Meta-II/LaTeXnote/Sun-机械设计基础课程设计.pdf

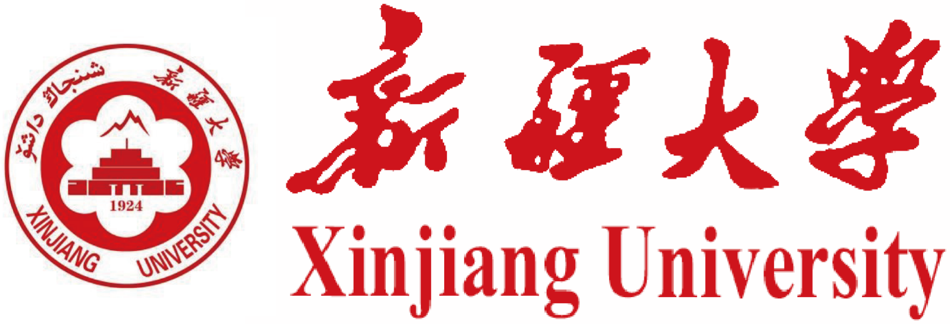
[picture p6: figure]

# 机械设计基础课程设计

# 说明书

## 设计题目： 带式运输机（二）

## 学生姓名： 田欣洋

学 号： 20192000226

## 所属院系： 机械工程学院

专 | 业： 机械工程
班 | 级： 材料 19-1 班

## 指导老师： 巴吾东·依不拉音

日 期： 2021.06.24

摘要

本文为机械设计基础的课程设计说明书文档，以蜗轮蜗杆减速器为例，从原 动机的选择开始到主要零部件的设计，一步步系统完备地设计出了减速器，本文 采取了 LATEX 排版，并使用了自动计算的命令，进一步简化了设计的繁琐步骤。 本文的源码可在github上获得 (https://github.com/Meta-II/LaTeXnote)

目 录

第一章 机械装置总体设计 | 3
第二章 传动零件的设计计算计 | 6
第三章 主要零部件设计 | 10
第四章 减速器箱体及附件的设计 | 19

新疆大学本科课程设计

参考文献 | 24

# 第一章 机械装置总体设计

1.1 任务书与方案拟定

本传动装置用于带式运输机, 其工作参数如下: 运输带工作拉力 2200 N, 运 输带工作速度 1.0 m/s, 运输带滚筒直径 380 mm 两班制工作, 连续单向运转, 工 作中有轻微振动. 运输带速度允许误差为 ±5% 使用期限为十年, 检修期间隔为 三年, 根据工作要求, 本设计拟采用蜗轮蜗杆减速器, 具体的传动装置简图如下:


图 1.1: 传动简图

其中 1: 电动机, 2: 弹性联轴器, 3: 蜗杆减速器, 4: 滚筒, 5: 带式运输机

1.2 原动机选择

1.2.1 电动机的选择

(1) 按照工作要求, 选择一般用途的 YE3 系列超高功率三相异步电动机, 电压 380V

(2) 选择电动机功率工作机所需效率为:

Pw =

F · v
1000

=

2200 · 1.0
1000

= 2.20 kW

传动装置总效率为:

η = η滚筒 · η联轴器 · η球轴承 · η蜗轮蜗杆 = 0.96¹

- 0.98³
- 0.99²
- 0.84 = 0.74

所需电动机功率为:

Pd =

Pw
η

= 2.96 kW =⇒ Ped = 3 kW

因为载荷平稳, 电动机额定功率 Ped 略大于 Pd 即可, 查表后, 选择电动机 的额定功率 Ped 为 3 kW.

(3) 确定电动机转速滚筒轴的工作转速为

nw =

60 · 1000 · 1.0
π · 380

= 50.26 m/s

一级蜗轮蜗杆减速器的传动比通常为 10 ∼ 20, 即 ia

′ = 10 ∼ 20, 故电动机
转速可选范围为:

nd
′ = ia

′ · nw = (10 ∼ 20) · nw = 502.59 ∼ 1005.19 m/s

符合这一范围的同步转速有 750r/min,1000r/min,查阅相关标准[1]
, 根据
功率, 转速, 挑选出以下两种型号电机, 并进行比较.
方案 | 电动机型号 | 额定功率 /kW | 同步转速/满载转速 nm | 重量 | 噪声 | 效率
1 | YE3-132S-6 | 3 | 1000/960(/ r/min) | 63kg | 69dB | 85.6%
2 | YE3-132M-8 | 3 | 750/730(/ r/min) | 61kg | 64dB | 82.5%

表 1.1: 电动机型号比较表

为了使传动装置结构紧凑稳固, 噪声更小, 效率更高, 选择方案 1, 确定电 机型号为 YE3-132S-6, 其主要参数: 满载转速 nm = 960 r/min, 中心高

H = 132 mm, 轴伸部分 D = 38 mm

1.2.2 传动比的分配

总传动比:ia =

| nm nw | =
| | 960
50.26 = 各个轴的传动比:i01 = 1,i12 = 19.10

1.2.3 传动系统运动与动力参数计算

0 轴 (电动机轴)

p0 = pd = 2.96 kW

n0 = nm = 960 r/min

T0 = 9550

P0
n0

= 9550 ×

2.96
960

= 29.42N · m

1 轴 (蜗杆轴)

p1 = p0η1 = 2.957491774667032 × 0.9702 = 2.87 kW

n1 =

n0

i01

=

960
1

= 960 r/min

T1 = 9550

P1
n1

= 9550 ×

2.87
960

= 28.54 N · m

2 轴 (蜗轮轴)

p2 = p1η2 = 2.87 × 0.84 = 2.41 kW

n2 =

n0

i12

=

960
19.10

= 50.26 r/min

T2 = 9550

P2
n2

= 9550 ×

2.41
50.26

= 457.98 N · m

根据以上计算结果, 列出各轴运动和动力参数表如下:

轴名 | 功率 P/kW | 转矩 T/N · m | 转速 | 传动比 | 效率
| 输入 | 输出 | 输入 | 输出 | n/(r/min) | i | η
电动机轴 | 3 | 2.96 | | 29.42 | 960
1 轴 | 2.87 | 2.84 | 28.54 | 28.26 | 960 | 1 | 0.97
2 轴 | 2.41 | 2.31 | 457.98 | 439.66 | 50.26 | 19.10 | 0.84

表 1.2: 各轴动力参数表

# 第二章 传动零件的设计计算计

根据第一章计算的数据: 电动机功率 Ped = 3 kW, 转速 n1 = 960 r/min, 传 动比 i12 = 19.10, 载荷平稳单向回转.

2.1 传动类型选择

根据 GB/T10085 − 1998 为了加工简便, 易于更换维修, 选择常用的右旋 渐开线蜗杆 (ZI 蜗杆), 精度等级为 7 级.

2.2 材料选择

根据工作要求, 蜗杆选择 45 号钢, 表面淬火处理, 硬度达到 45 ∼ 55 SRC, 蜗 轮选择含锡量较低的 5-5-5 ZCuSn5Pb5Zn5 的锡青铜金属模制造, 轮芯采用灰铸 铁 HT100 制造,

2.3 参数选择与强度计算

2.3.1 传动比计算

在较大的传动功率下, 为了提高效率, 采用多头蜗杆, 取 Z1 = 2, 取传动比为

19, 则误差为 ∆ = 19.101−19
19.101 ×100% = 0.53%, 在误差允许范围内. 再根据效率传动 比与蜗杆头数, 蜗轮齿数的关系:i12 =
| n1
| n2 = Z2
| Z1 , 计算得到:Z2 = Z1 · i12 = 2 · 19 =
38, 查表 12-8, 估计 η = 0.8

2.3.2 强度计算

因为圆柱蜗杆传动的主要失效形式为蜗轮轮齿表面产生胶合, 点蚀, 磨损, 所以根据蜗轮齿面疲劳接触强度进行设计计算. 已知蜗轮所受的的转矩 T2 = 457.983, 因为工作转速不大, 工作冲击不大, 环境温度不高, 故选择使用系数 KA = 1.20.因为蜗杆采用 45 号钢, 其硬度大于 45SRC, 蜗轮选择 ZCuSn5Pb5Zn5 的锡 青铜金属模制造, 单向旋转, 根据表 12-2 选取综合弹性系数 Ze = 160 , 查表 12-4, 许用接触应力 [σH] = 220Mpa, 查表 12-6, 许用弯曲用力 [σF ] = 28Mpa. Zp 为

接触系数, 先假设蜗杆分度圆直径 d1 和中心矩 a 的比值 d1 a = 0.37, 查表得到

Zp = 2.8.
根据赫兹公式, 得到蜗轮齿面疲劳接触强度的设计公式如下

a ≥
3

√

KAT

(ZeZp

[σH]

)2

所以中心矩为:

a ≥

3

√

1.20 × 447284.28 × 10³

(160 × 2.8

220

)2
= 131.597 mm

2.3.3 参数确定

### 1. 参数的估算与选择

d1 ≈ 0.68a

0.875 = 0.68 × 130.565⁰.875 = 48.62 mm

m ≈

2a − d1
Z2

=

2 × 130.565 − 48.290
38

= 5.646 mm

a = 0.5m(q + Z2) = 0.5 × 6.3(10 + 38) = 151.2 mm > 131.597 mm

查表 12-1 选择 m = 6.3 mm, d1 = 63 mm, q = 10.00, d2 = mZ2 = 6.3·38 =

239.4 mm 因为 a = 151.2 mm > 131.597 mm 故接触强度足够. 由蜗轮传动中心 矩的标准系列 (...,80,100,125,160,180,...), 选取中心矩 a = 160 mm, 但如果选取 此值, 则会引起传动比变化, 而且对于模数 m = 6.3 而言, 不存在任何整数齿数 使得 a = 160, 在改变传动比的情况下, 要圆整中心矩会导致工作机转速达不到 要求, 在不改变传动比的情况下要圆整, 需要在滚切蜗杆时将滚刀相对于蜗轮中 心向外移动 8.8mm, 假设这样做引起的变位系数在正常范围内, 那么就采取变位 传动方式.

### 2. 最终参数 根据以上计算结果, 蜗杆的具体参数如下表所示:

蜗杆参数

分度圆直径 | d1 = mq = 6.3 · 10 = 63 mm
分度圆导程角 | γ = arctan Z1 q = arctan(
| 2

10 ) = 11.31◦

齿顶高 | ha = m = 6.3 mm
齿根高 | hf = 1.2m = 1.2 · 6.3 = 7.56 mm
齿顶圆直径 | da1 = m(q + 2) = 6.3 · (10 + 2) = 75.6 mm
齿根圆直径 | df1 = m(q − 2.4) = 6.3 · (10 − 2.4) = 47.88 mm
轴向齿距 | Pa = πm = 19.792 mm
轴向齿厚 | Sa = 1/2 πm = 9.896 mm
法向齿厚 | Sn = Sa · cos γ = 9.704 mm

表 2.1: 蜗杆轮齿参数表

蜗轮的具体参数如下表所示:

| 蜗轮参数
分度圆直径 | d2 = mZ2 = 6.3 · 38 = 239.4 mm
齿顶高 | ha = m = 6.3 mm
齿根高 | hf = 1.2m = 1.2 · 6.3 = 7.56 mm
喉圆直径 | da2 = m(Z2 + 2) = 6.3 · (38 + 2) = 252 mm
齿顶圆直径 | de2 ≤ da2 + 1.5m = 261.45 mm
齿根圆直径 | df2 = m(Z2 − 2.4) = 6.3 · (38 − 2.4) = 224.28 mm
轮缘宽度 | B ≤ 0.75da1 = 0.75 · 75.6 = 56.7 mm
轮圈宽度 | C = 1.65m + 1.5 = 10.389 + 1.5 = 11.895 mm

表 2.2: 蜗轮参数表

2.4 参数校核

2.4.1 强度校核

根据以上的最终参数, 按齿根弯曲强度进行校核, 校核公式如下:

σF =

1.53KAT2YF a2
d1d2m cos λ

≤ [σF ]

当量齿数: ZY 2 =

Z2
cos³ λ =

38
cos³ 11.31◦ = 40.303 ≈ 41 齿形系数: 根据 ZY 2 = 41, 从图 11-9 中可以查得齿形系数 YF a = 2.45 螺旋角系数: Yβ = 1 −

σ
140◦ =
1 −

11.31◦
140◦ = 0.9192 之前查表得: 许用弯曲用力 [σF ] = 30Mpa 蜗轮齿根弯曲应

力:

σF =

1.53KAT2YF a2
d1d2m cos λ

=

1.53 × 1.2 × 457983 × 2.45 63 × 239.4 × 6.3 × cos 11.31◦

= 22.11 Mpa < [σF ] = 28 Mpa

满足弯曲强度. 对 Zp 校核:

d1
a =

63
160 = 0.394, 查表可得 zp

′ = 2.75 < 2.9, 故以上
计算过程有效.

2.4.2 传动效率校核

蜗杆转速:V1 = πn D1
60·1000 = 3.12 m/s 蜗轮转速:V2 =

V1
cos(γ) = 3.23 m/s 传动
效率:

η =

tanλ
tan(λ + ρ

′
)

=

tan11.31◦
tan(11.31◦ + 1.37◦
)

= 0.88 > 0.84

效率大于之前的估计值, 可以使用.

2.4.3 热平衡计算

### 1. 估算散热面积 A A = 0.33 ·

(

160

100)1.75
= 0.75 m²

### 2. 验算油的工作温度 ti 室温下 t0 = 20◦, 散热系数 : αt = 13 W/(m²

·

◦C) 可
以计算 ∆t:

∆t =

1000(1 − η)P1
αtA

=

1000(1 − 0.84) · 2.87
αtA

= 47.1 < 60 ◦C

所以 tmax = 20 + 47.1 = 67.1 < 90, 没有超过温度允许值, 故不需要采取冷却措 施.

# 第三章 主要零部件设计

3.1 轴的设计

3.1.1 蜗杆的结构设计

### 1. 方案确定 一级蜗轮蜗杆减速器可以将蜗杆安排在箱体中间, 两侧滚动轴承

成对分布, 轴承用轴肩定位, 一段固定, 一端游离, 联轴器用平键连接定位. 蜗杆 上的参数:功率 P1 = 2.96 kW, 转速 N1 = 960 r/min, 转矩 T1 = 28.54 N · m

### 2. 按纯扭转初步估算最小轴径 由于轴选择的是 45 号钢, 查表 14-2 得 [t] =

30 ∼ 40, C = 117 ∼ 107, 这里选取 C = 110, 对于只受转矩的轴而言, 其设计公 式为:

d ≥ C

3

√
P
n

= 110 ·

3

√
3.181
960

= 15.85 mm

由于轴上含有键槽, 故增大 3% 的直径:d = 15.85 · 103% = 16.32 mm =⇒ d =

20.00 mm

### 3. 轴上各段参数的确定

(1) I 端 (联轴器端) 联轴器的选取: 根据所受转矩 T1 = 28.54 N · m, 则联 |d1 = 32 轴器所受转矩为: Tca = KAT1 = 1.3 × 28.54 = 37.11 N · m, 根据电动 |L1 = 88 机输入轴参数, 与公称直径的要求, 查表 6-96(P146) 选取弹性套柱销联轴

器 LT5 ZC44×28
32×82 GB/T 4323-2017, 考虑到联轴器的安装尺寸, 所以这里取

d1 = 32 mm, L1 = 82 + 6 = 88 mm

键的选择: 根据轴的公称直径, 查表 6 − 54(P111), 选取 A 型平键, 剖面尺寸 为:10 × 8, 键长 l 取 88-8=80 mm, 即 GB/T 1096 10 × 8

(2) II 端 (左侧轴承端盖端) 因为定位键高度 h = 10 mm 查表得嵌入到轴的深 |d2 = 42 度为 5, 则伸出的高度为:5 mm,d2 = d1 + 2h = 42 mm, 选取凸缘式轴承盖, |L2 = 50 其总长为 20 mm, 取轴承端盖外端面与联轴器内端面距离为 L = 30 mm,

所以 L2 = 30 + 20 = 50 mm

(3) III 端 (轴承端) 根据此轴的受力与轴的公称直径, 查表 6-64P126, 暂选圆 |d3 = 45

|L3 = 22
|L3
′ =

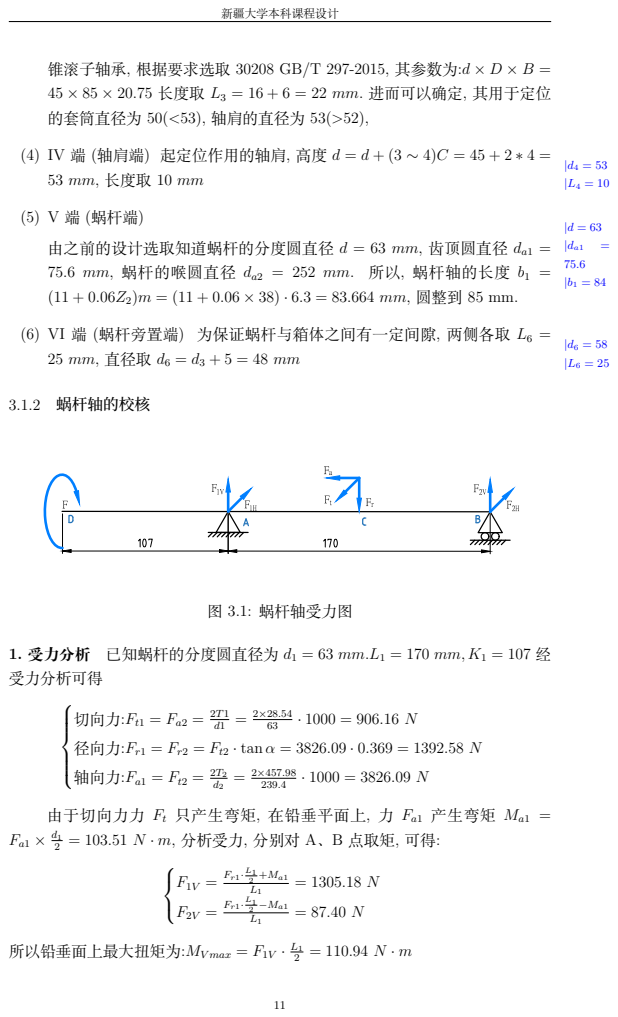
[picture p7: page 13]
53 mm, 长度取 10 mm; (5) V 端 (蜗杆端); 25 mm, 直径取 d6 = d3 + 5 = 48 mm; 3.1.2 蜗杆轴的校核; 图 3.1: 蜗杆轴受力图; 切向力:Ft1 = Fa2 =; 径向力:Fr1 = Fr2 = Ft2 · tan α = 3826.09 · 0.369 = 1392.58 N; 轴向力:Fa1 = Ft2 =

锥滚子轴承, 根据要求选取 30208 GB/T 297-2015, 其参数为:d × D × B =
45 × 85 × 20.75 长度取 L3 = 16 + 6 = 22 mm. 进而可以确定, 其用于定位
的套筒直径为 50(<53), 轴肩的直径为 53(>52),

(4) IV 端 (轴肩端) 起定位作用的轴肩, 高度 d = d + (3 ∼ 4)C = 45 + 2 ∗ 4 =

由之前的设计选取知道蜗杆的分度圆直径 d = 63 mm, 齿顶圆直径 da1 =
75.6 mm, 蜗杆的喉圆直径 da2 = 252 mm. 所以, 蜗杆轴的长度 b1 =
(11 + 0.06Z2)m = (11 + 0.06 × 38) · 6.3 = 83.664 mm, 圆整到 85 mm.

(6) VI 端 (蜗杆旁置端) 为保证蜗杆与箱体之间有一定间隙, 两侧各取 L6 = |d6 = 58

1. 受力分析 已知蜗杆的分度圆直径为 d1 = 63 mm.L1 = 170 mm, K1 = 107 经
受力分析可得

由于切向力力 Ft 只产生弯矩, 在铅垂平面上, 力 Fa1 产生弯矩 Ma1 =
2 = 103.51 N · m, 分析受力, 分别对 A、B 点取矩, 可得:

所以铅垂面上最大扭矩为:MV max = F1V ·

在水平面上, 由平面力系平衡方程可得水平面的支撑反力:

F1H =

Ft1·

L1
2
L1

= 453.08 N

F1H =

Ft1·

L1
2
L1

= 453.08 N

所以水平面上最大扭矩为:MHmax = F1H ×

L1
2 = 38.51 N · m
左侧的转矩为:M1 = 28.54, 所以危险截面 C 的扭矩为:Mmax = MHmax +

MV max + M1 = 177.99 N · m

### 2. 扭矩图 经过以上计算可以画出蜗杆轴的扭矩图如下:

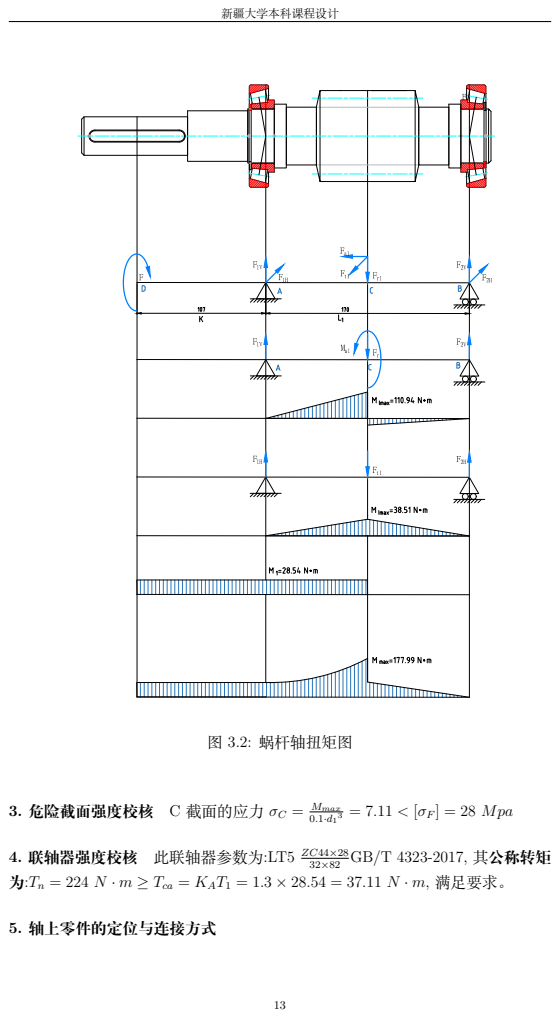
[picture p8: page 15]
图 3.2: 蜗杆轴扭矩图; Mmax 0.1·d1; 3 = 7.11 < [σF ] = 28 Mpa; 32×82 GB/T 4323-2017, 其公称转矩; 5. 轴上零件的定位与连接方式

3. 危险截面强度校核 C 截面的应力 σC =

4. 联轴器强度校核 此联轴器参数为:LT5 ZC44×28
为:Tn = 224 N · m ≥ Tca = KAT1 = 1.3 × 28.54 = 37.11 N · m, 满足要求。

(1) 联轴器与轴采用 A 型平键定位连接连接, 参数为:GB/T 1096 键 20×70, 采用完全对称偏差配合.
(2) 轴承端盖通过轴承套筒定位, 不与轴连接.
(3) 套筒通过凸台, 轴肩定位, 与轴采用间隙配合 H7
h6
(4) 滚动轴承用轴肩定位, 采用过盈配合 P7
h6

,

### 6. 蜗杆轴 (高速轴) 键的校核 设载荷为均匀分布，可以计算得到该平键的挤压

强度条件：

σp =

4T
dhl =

4 · 28.54 · 10²
20 · 12 · 70

= 6.80 ≤ [σp] = 60 MP a

选取 45 钢作为轮毂的材料，由以上计算可知，键的选取满足要求。

### 7. 轴承的校核 轴承选取 30208 GB/T 297-2015, 其参数为:d×D×B = 45×85×

20.75 长度为 L3 = 16 + 6 = 22 mm，其额定动载荷为 Cr = 63000 N 极限转速为 5000，寿命取 10000h 由受力分析易得左端为压紧端，查表可得 ft(温度系数) =

1, fp(载荷系数) = 1.2, ϵ =

3
10 由公式

Cr =

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
63000 =

1.2 × P
1

(

60 × 960
10⁶

× 10⁴
)

3
10

P = Fr =

52500
576⁰.3

= 7798 > 1392.58 N

所以轴承满足要求。

3.1.3 蜗轮轴的结构设计

### 1. 方案确定 一级蜗轮蜗杆减速器可以将蜗轮安排在箱体中间, 两侧滚动轴承

成对分布, 轴承用轴肩定位, 一段固定, 一端游离, 分别从左右两侧装入蜗轮左面 用轴肩定位, 右面用轴端盖定位, 轴向采用键和过渡配合, 联轴器用平键连接定 位.
蜗轮轴的参数:功率 P2 = 2.41 kW, 转速 N2 = 50.26 r/min, 转矩 T2 = 457.98 N ·

m

### 2. 按纯扭转初步估算轴径 计算轴上受力: (1) 蜗轮轴向力 Fa2 = Ft1 = 906.16 N

(2) 蜗轮周向力 Ft2 = Fa1 = 3826.09 N (3) 蜗轮径向力 Fr2 = Fr1 = 1392.58 N 由于轴选择的是 45 号钢, 查表 14-2 得 [t] = 30 ∼ 40, C = 117 ∼ 107, 这里选取 C = 110, 对于只受转矩的轴而言, 其设计公式为:

d ≥ C

3

√
P2
n2

= 110 ·

3

√
2.41
50.26

= 39.96 mm

由于轴上含有键槽, 故增大 3% 的直径:d = 39.96 · 103% = 41.16 mm =⇒ d =

46 mm

### 3. 轴上各段参数的确定

(1) I 端 (联轴器端) 联轴器的选取: 根据所受转矩 T2 = 457.98 N · m, 则联轴 |d1 = 50

|L1 = 84

|L = 70

器所受转矩为: Tca = KAT1 = 1.3 × 457.98 = 595.37 N · m, 根据公称直径
的要求, 查表选取弹性套柱销联轴器 LT8 50×84
60×142GB/T 4323-2017(蜗轮轴为
主动端,), 轴上键槽取 18 × 10, L = 70 mm.
(2) II 端 (左侧轴承端盖端) 取定位销键高度 h = 10 mm, 轴肩高度 d2 = |d2 = 62 d1 + 2 × 6 = 62 mm 轴承端盖总长为 20 mm, 取轴承端盖外端面与联轴器 |L2 = 55

内端面距离为 L = 20 mm, 所以 L2 = 35 + 20 = 55 mm

(3) III 端 (轴承端) 根据此轴的受力情况, 暂选圆锥滚子轴承, 根据要求选取 |d3 = 70 30214 GB/T 297-2015, 其参数为:d×D×B = 70×125×22 考虑到角接触球 |L3 = 50 轴承右端用套筒来向轴肩定位, 轴承右端面距齿轮中心距离为 63 mm, 轴

承宽度 B = 22 mm, 左端伸出 2 mm, 所以 dz1 = 24−2 = 20 mm, 凸台宽度

15 mm, 套筒长度 11 mm, 轮伸出 4 mm, 所以轴承端 L3 = 15+11+20+4 =

50 mm

(4) V 端 (蜗轮端) 为了安装蜗轮, 选取 d4 = 66 mm, 蜗轮齿宽 L = 0.75 ·
|d4 = 66
75.6 = 56.7 mm, 为了能压紧蜗轮, 取 L4 = 66 mm | |L4 = 66
| |d5 = 90
|L5 = 10 (5) V 轴肩端为了轴环的轴向定位, 取 d5 = 90 mm,L5 = 10 mm
| |d6 = 70
|L6 = 38 (6) 端盖端根据端盖的要求, 选取 d6 = 70 mm 让两侧中心距一致, 取凸台宽度

13, 轴承宽度 20, 端盖上 e = 12, m = 18, m − e1 = 5, , e1 = 13(e), 所以

L6 = 5 + 20 + 13 = 38 mm

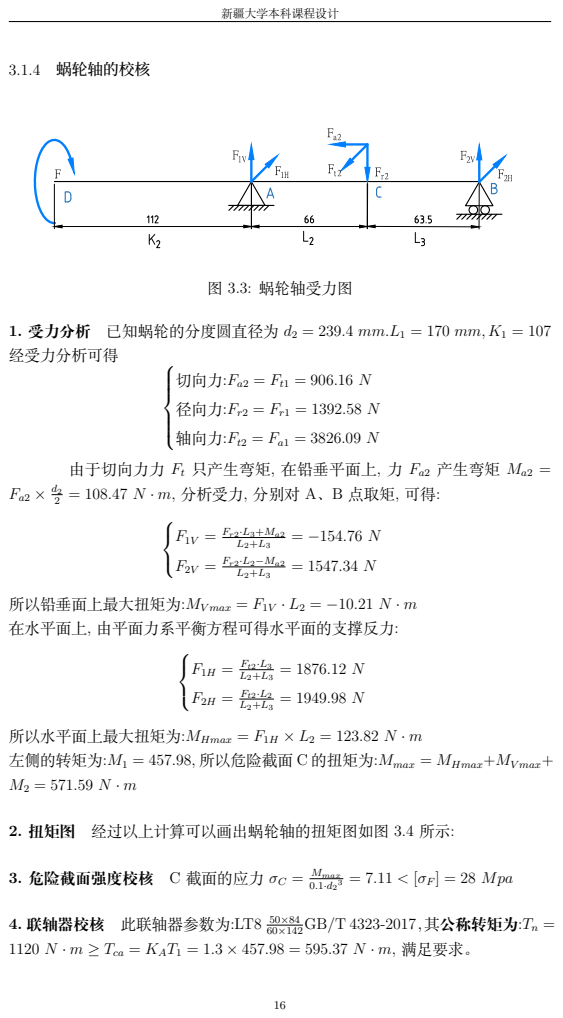
[picture p9: page 18]
3.1.4 蜗轮轴的校核; 图 3.3: 蜗轮轴受力图; 切向力:Fa2 = Ft1 = 906.16 N; 径向力:Fr2 = Fr1 = 1392.58 N; 轴向力:Ft2 = Fa1 = 3826.09 N; Mmax 0.1·d2; 3 = 7.11 < [σF ] = 28 Mpa; 4. 联轴器校核 此联轴器参数为:LT8 50×84 60×142GB/T 4323-2017，其公称转矩为:Tn =; 1120 N · m ≥ Tca = KAT1 = 1.3 × 457.98 = 595.37 N · m, 满足要求。

1. 受力分析 已知蜗轮的分度圆直径为 d2 = 239.4 mm.L1 = 170 mm, K1 = 107
经受力分析可得

由于切向力力 Ft 只产生弯矩, 在铅垂平面上, 力 Fa2 产生弯矩 Ma2 =
2 = 108.47 N · m, 分析受力, 分别对 A、B 点取矩, 可得:

所以铅垂面上最大扭矩为:MV max = F1V · L2 = −10.21 N · m
在水平面上, 由平面力系平衡方程可得水平面的支撑反力:

所以水平面上最大扭矩为:MHmax = F1H × L2 = 123.82 N · m
左侧的转矩为:M1 = 457.98, 所以危险截面 C 的扭矩为:Mmax = MHmax+MV max+

2. 扭矩图 经过以上计算可以画出蜗轮轴的扭矩图如图 3.4 所示:

3. 危险截面强度校核 C 截面的应力 σC =

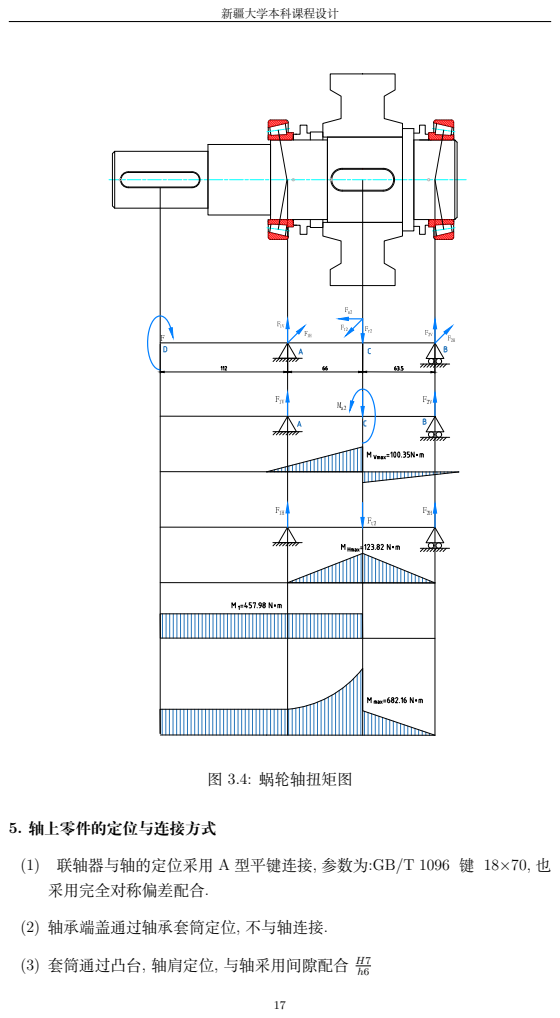
[picture p10: page 19]
图 3.4: 蜗轮轴扭矩图; 5. 轴上零件的定位与连接方式; (2) 轴承端盖通过轴承套筒定位, 不与轴连接.

(1) 联轴器与轴的定位采用 A 型平键连接, 参数为:GB/T 1096 键 18×70, 也
采用完全对称偏差配合.

(3) 套筒通过凸台, 轴肩定位, 与轴采用间隙配合 H7

(4) 滚动轴承用轴肩定位, 采用过盈配合 P7
h6

,

(5) 出轮轮毂与轴采用过盈配合 H7
r6

### 6. 蜗轮轴 (低速轴) 键的校核 设载荷为均匀分布，可以计算得到该平键的挤压

强度条件：

σp =

4T
dhl =

4 · 457.98 · 10²
18 · 10 · 70

= 14.54 ≤ [σp] = 60 MP a

选取钢作为轮毂的材料，由以上计算可知，键的选取满足要求。

### 7. 轴承的校核 根据所选参数可知, 蜗轮轴上的滚动轴承参数为：轴承选取

30214 GB/T 297-2015, 其参数为:d×D×B = 70×125×22 长度为 L3 = 15+11+

24 = 50 mm，其额定动载荷为 Cr = 132000 N 极限转速为 3000，寿命取 10000h 由受力分析易得右端为压紧端，查表可得 ft(温度系数) = 1, fp(载荷系数) =

1, ϵ =

3
10 由公式

Cr =

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
132000 =

1 × P
1

(

60 × 50
10⁶

× 10⁴
)

3
10

P = Fr =

132000
30⁰.3

= 4785 > 3826.09 N

所以轴承满足要求。

# 第四章 减速器箱体及附件的设计

根据计算的数据与经验, 求得箱体的推荐尺寸如下:

箱座壁厚 | δ = 9.4 mm | 0.04a + 3 ≥ 8 mm
箱盖壁厚 | δ1 = 9.4 mm | ≈ δ
箱座凸缘厚度 | b = 14.1 mm | 1.5δ
箱盖凸缘厚度 | b1 = 14.1 mm | 1.5δ1
箱座底凸缘厚度 | b2 = 23.5 mm | 2.5δ
地脚螺栓直径 | df = 17.76 mm | 0.036a + 12
地脚螺栓数目 | n = 4 mm | 4
轴承旁联接螺栓直径 | d1 = 13.32 mm | 0.75df
箱盖与箱座联接螺栓直径 | d2 = 8.88 ∼ 10.66 | (0.5 ∼ 0.6df
联接螺栓 d2 的间距 | l = 175 mm | 150 ∼ 200
轴承端盖螺钉直径 | d3 = 7.10 ∼ 8.88 | (0.4 ∼ 0.5)df
窥视孔盖螺钉直径 | d4 = 5.32 ∼ 7.10 | (0.3 ∼ 0.4)df
定位销直径 | d | (0.7 ∼ 0.8)d2
轴承旁凸台半径 | R1 | c2
凸台高度 | h | d1
外箱壁到轴承座端面距离 | l1 | c1 + c2(5 ∼ 8)
蜗杆外圆与内壁距离 | ∆1 > 11.28 | > 1.2δ
蜗轮轮毂端面与内壁距离 | ∆2 > 9.40 | > δ
箱盖肋厚、拉拉 | m1 = 7.99 mm | m1 ∼ 0.85δ1
箱座肋厚 | m2 = 7.99 mm | m2 ∼ 0.85δ
轴承端盖外径 | D2 | 4D + (5 ∼ 5.5)d3
轴承端盖凸缘厚度 | t | (1 ∼ 1.2d3)
轴承旁联接螺栓距离 | S | S ∼ D2

表 4.1: 箱体经验尺寸

4.1 检查孔和视孔盖

检查孔用于检查传动件的啮合情况、润滑状态、接触斑点及齿侧间隙，还可 用来注入润滑油，故检查孔应开在便于观察传动件啮合区的位置，其尺寸大小 应便于检查操作。
视孔盖可用铸铁、钢板制成，它和箱体之间应加密封垫，还可在孔口处加过 滤装置，以过滤注入油中的杂质。参照表

4.2 放油螺塞

放油孔应设在箱座底面最低处或设在箱底。箱外应有足够的空间，以便于放 容器，油孔下也可制出唇边，以利于引油流到容器内。放油螺塞常为六角头细牙 螺纹，在六角头与放油孔的接触面处，应加封油圈密封。放油螺塞及对应油封圈 尺寸如下图所示：

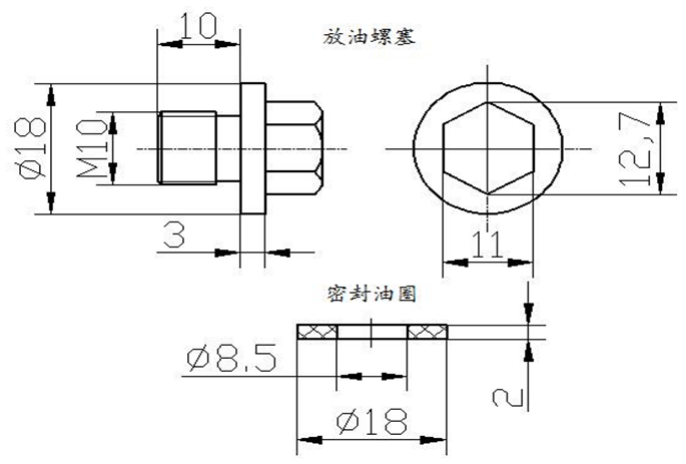
[picture p11: figure]

图 4.1: 放油螺塞

4.3 油标

油标用来指示油面高度，应设置在便于检查及油面较稳定之处。本设计采 用杆式油标，杆式油标结构简单，其上有刻线表示最高及最低油面。油标安置的 位置不能太低，以防油溢出。其倾斜角度应便于油标座孔的加工及油标的装拆。 查辅导书手册，具体结构和尺寸如下：

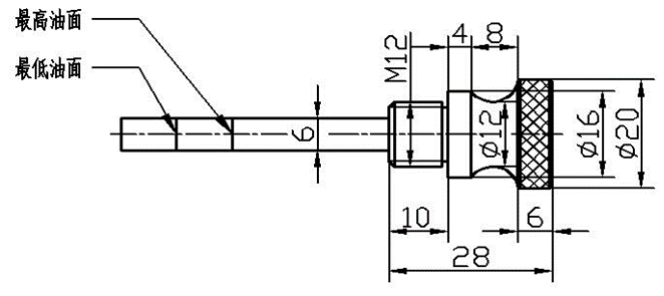
[picture p12: figure]

图 4.2: 油标

4.4 通气器

通气器用于通气，使箱体内外气压一致，以避免由于运转时箱体内温度升 高，内压增大，而引起减速器润滑油的渗漏。简易的通气器钻有丁字形孔，常设 置在箱顶或检查孔盖上，用于较清洁的环境。较完善的通气器具有过滤网及通 气曲路，可减少灰尘进入。查辅导书手册，本设计采用通气器型号及尺寸如下：

4.5 起吊装置

起吊装置用于拆卸及搬运减速器。它常由箱盖上的吊孔和箱座凸缘下面的 吊耳构成。也可采用吊环螺钉拧入箱盖以吊小型减速器或吊起箱盖。本设计中 所采用吊孔（或吊环）和吊耳的示例和尺寸如下图所示：


图 4.3: 吊耳

4.6 起盖螺钉

为便于起箱盖，可在箱盖凸缘上装设 2 个起盖螺钉。拆卸箱盖时，可先拧 动此螺钉顶起箱盖。起盖螺钉钉头部位应为圆柱形，以免损坏螺纹。本设计起盖 螺钉尺寸如下:

4.7 定位销

保证箱体轴承孔的加工精度与装配精度，应在箱体连接凸缘上相距较远处 安置两个圆锥销，并尽量放在不对称位置，以使箱座与箱盖能正确定位。为便于 装拆，定位销长度应大于连接凸缘总厚度。本设计定位销尺寸如下：

# 设计小结

这次关于蜗轮蜗杆减速器（闭式齿轮传动）的课程设计是我们真正理论联系 实际、深入了解设计概念和设计过程的实践考验, 对于提高我们机械设计的综合 素质大有用处。通过两个星期的设计实践, 使我对机械设计有了更多的了解和认 识, 为我们以后的工作打下了坚实的基础.

1. 机械设计是机械工业的基础, 是一门综合性相当强的技术课程, 它融《机械 原理》、《机械设计》、《理论力学》、《材料力学》、《公差与配合》、《CAD 实 用软件》、《机械工程材料》、《机械设计手册》等于一体。
2. 这次的课程设计, 对于培养我们理论联系实际的设计思想; 训练综合运用机 械设计和有关先修课程的理论, 结合生产实际关系和解决工程实际问题的 能力; 巩固、加深和扩展有关机械设计方面的知识等方面有重要的作用。
3. 在这次的课程设计过程中, 综合运用先修课程中所学的有关知识与技能, 结 合各个教学实线环节进行机械课程的设计, 一方面, 逐步提高了我们的理论 水平、构思能力、工程洞察力和判断力, 特别是提高了分析问题和解决问 题的能力, 为我们以后对专业产品和设备的设计打下了宽广而坚实的基础
4. 设计中还存在不少错误和缺点, 需要继续努力学习和掌握有关机械设计的 知识, 继续培养设计习惯和思维从而提高设计实践操作能力
5. 本次设计得到了指导老师的细心帮助和支持。衷心的感谢老师的指导和帮 助.

# 参考文献

[1] 《GB/T 28575-2012 YE3 系列 (IP55) 超高效率三相异步电动机技术条件》
[2] 濮良贵、陈国定、吴立言.《机械设计第 9 版》. 北京，高等教育出版社，
[3] 龚桂义. 机械设计课程设计图册
[4] 王之栎, 王大康. 机械设计综合课程设计 [M]. 机械工业出版社, 2009.
[5] 陈云飞卢玉明. 机械设计基础 (第 7 版)[M]. 高等教育出版社, 2008.
[6] 同济大学、上海交通大学等院校《机械制图》编写组. 机械制图. 第 6 版 [M]. 高等教育出版社, 2010.
