Meta-II/LaTeXnote/photos/蜗杆轴受力图.pdf

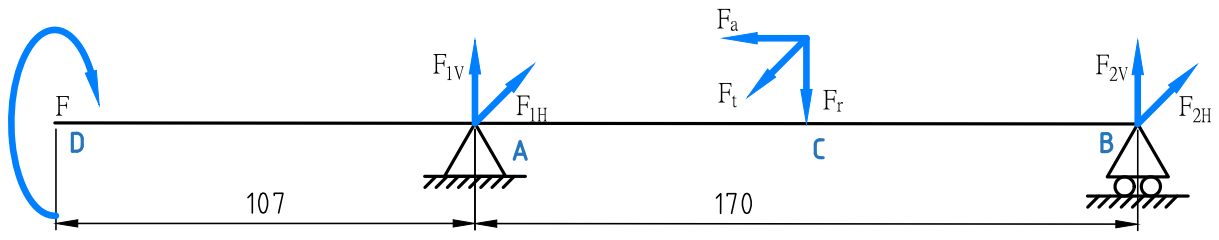
[picture p13: page 1]
