Meta-II/LaTeXnote/photos/蜗杆轴扭矩图.pdf

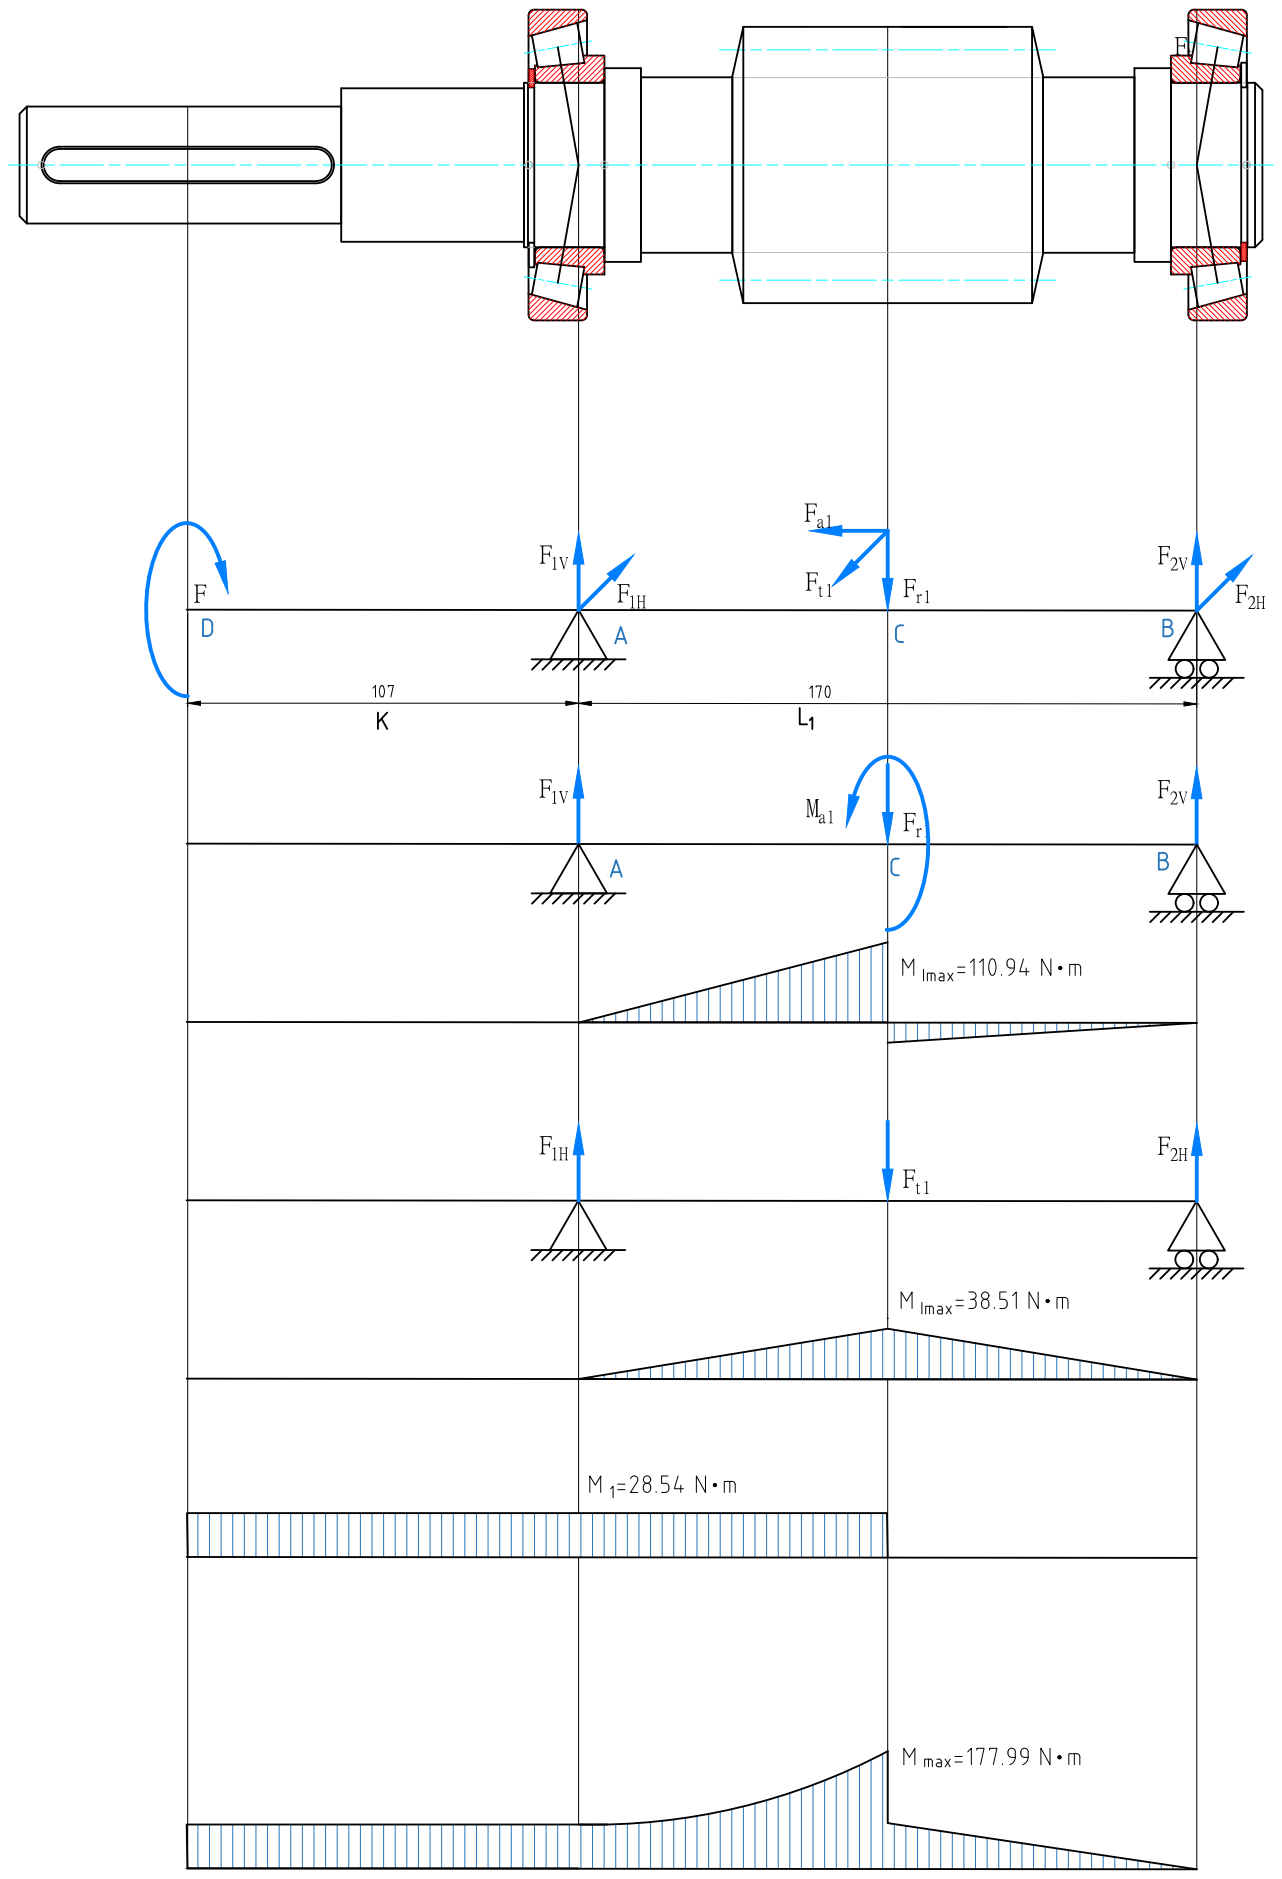
[picture p14: page 1]
