Meta-II/LaTeXnote/photos/蜗轮轴受力图.pdf

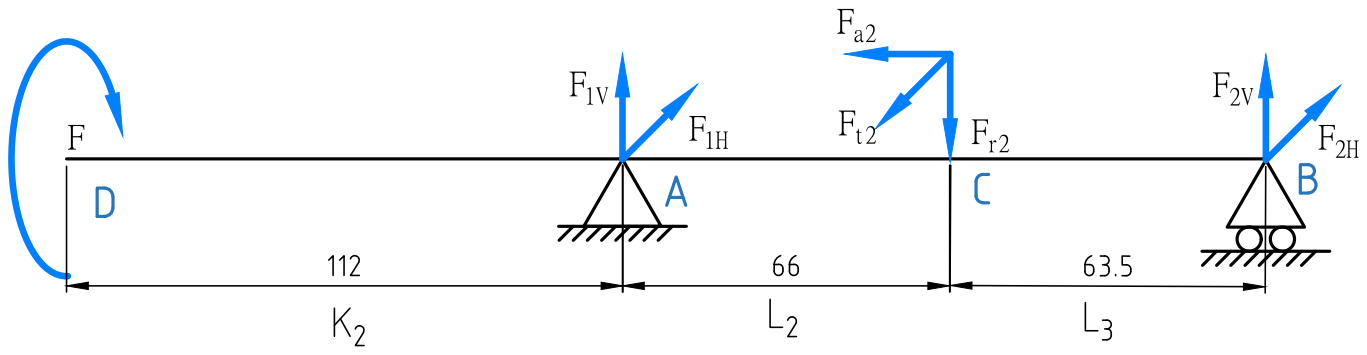
[picture p15: page 1]
