Meta-II/LaTeXnote/photos/蜗轮轴扭矩图.pdf

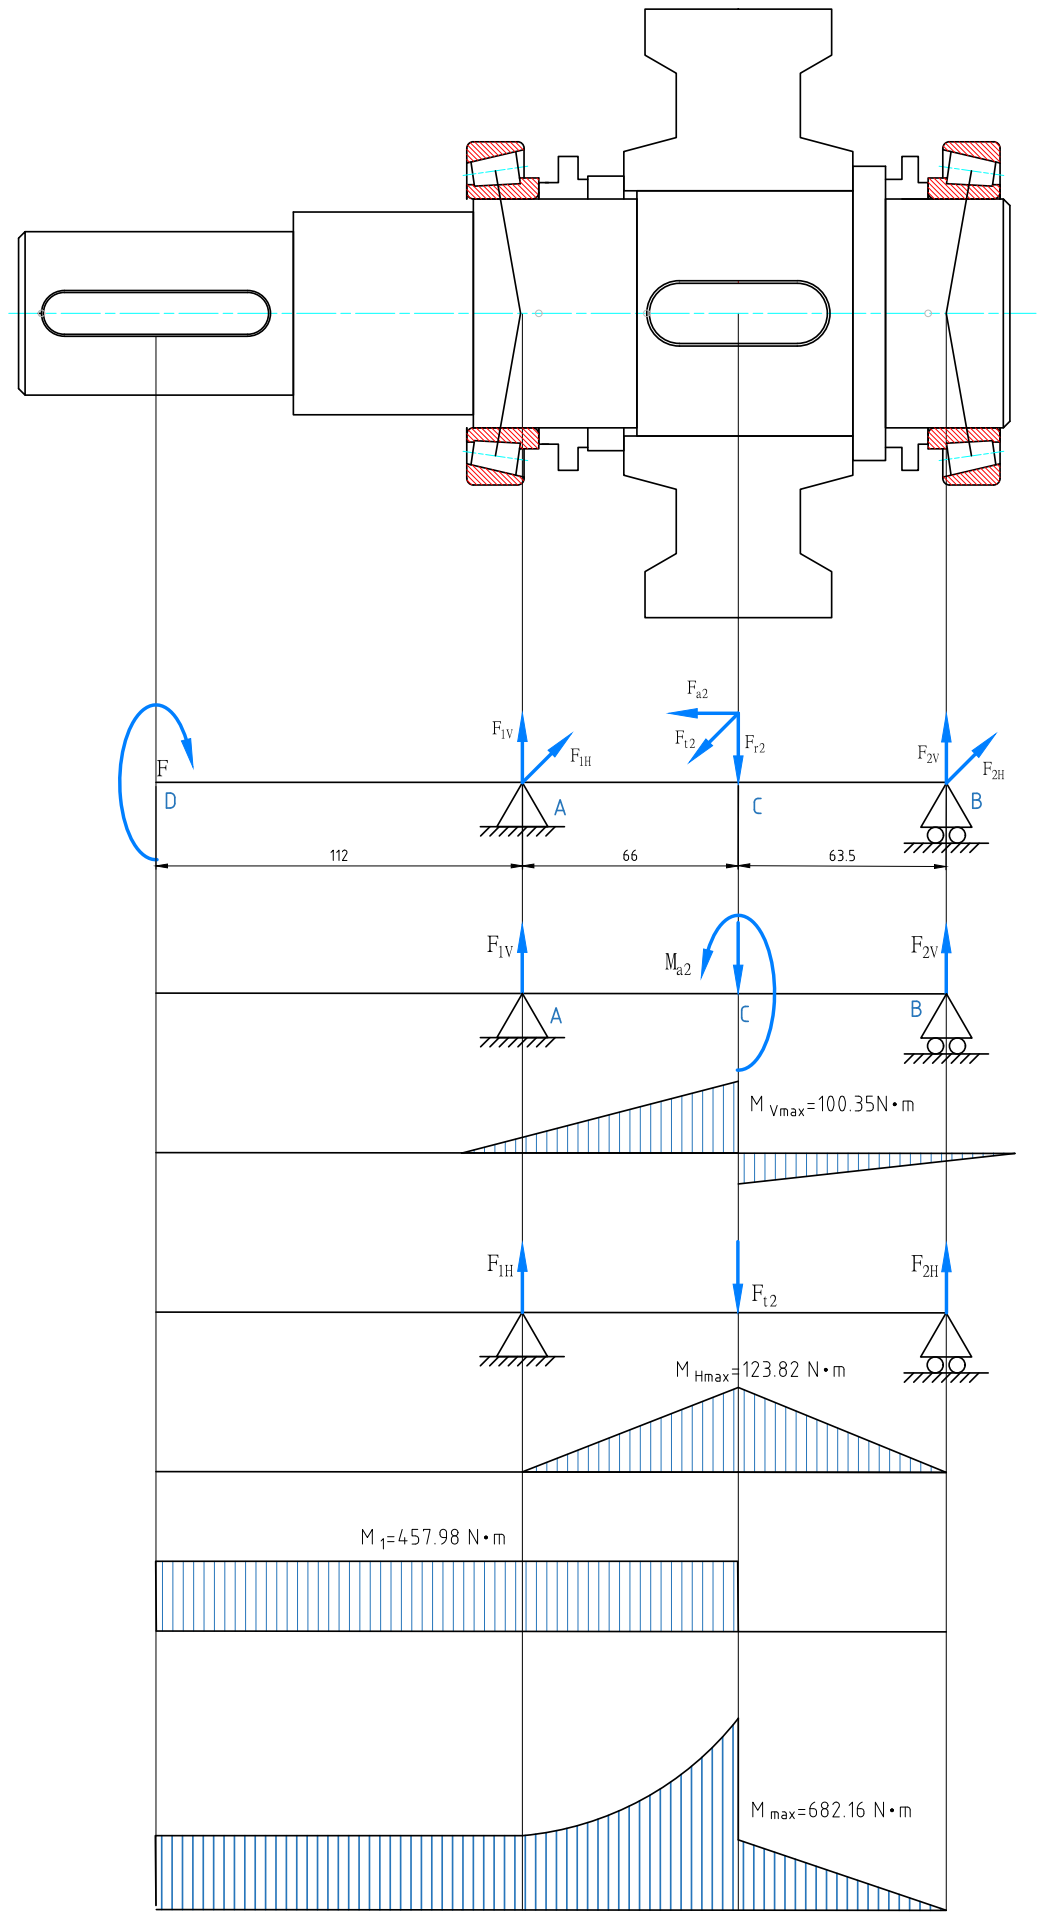
[picture p16: page 1]
