Meta-II/LaTeXnote/(list of files, cad)

Other CAD files:
CAD图/轴6-20--19_45.dwg
CAD图/轴.dwg
CAD图/轴受力图.dwg
CAD图/6-18-15_52轴.dwg
